Dpushp/UAV-uGV-system/PCB Design files/pcb schematics .png

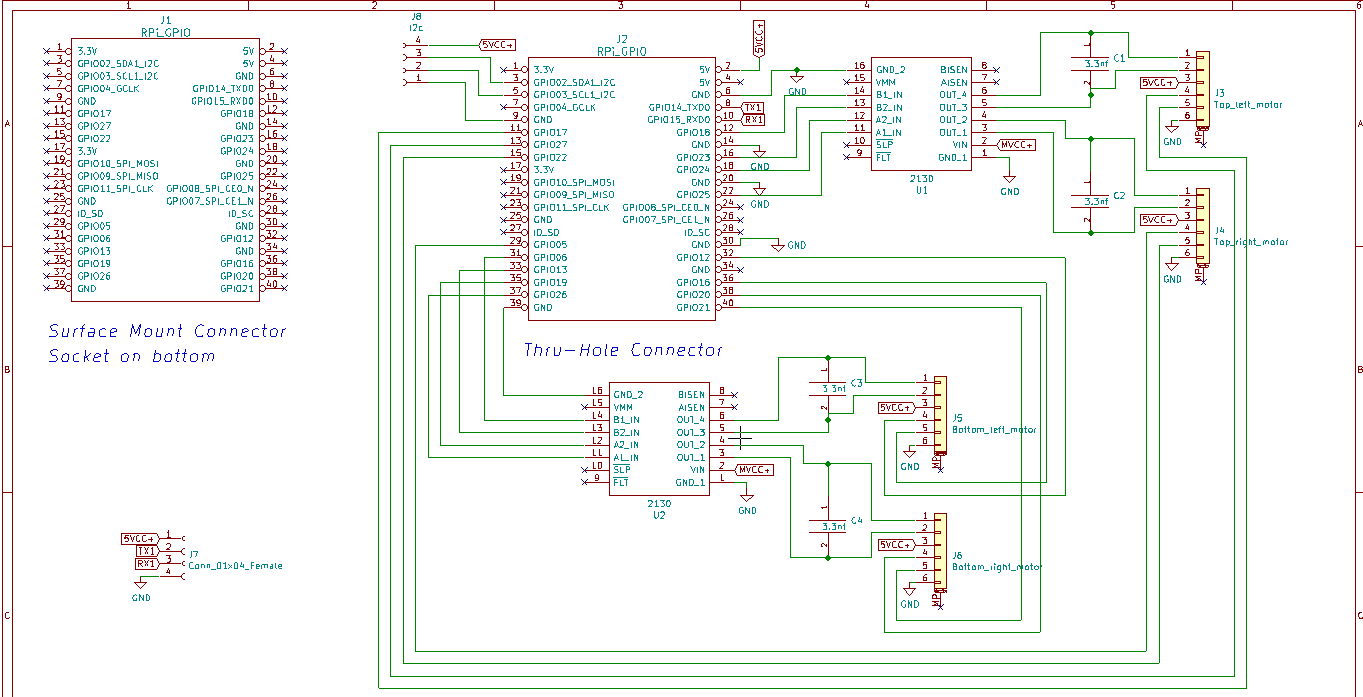
PCB Design files/pcb schematics .png
