Dpushp/UAV-uGV-system/ROS/src/realsense-ros/realsense2_description/meshes/plug.stl

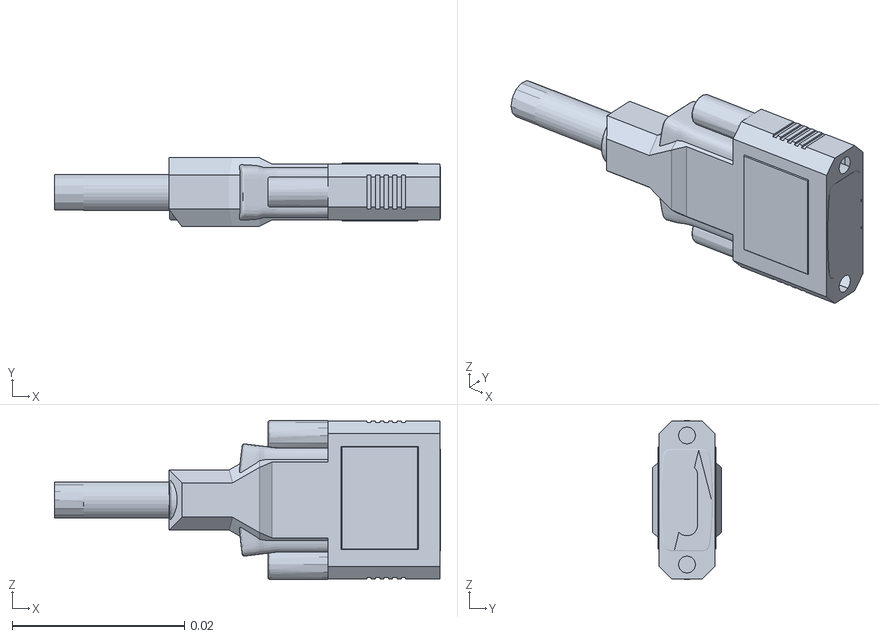
[picture p12: CAD file, 2021-03-01]
ROS/src/realsense-ros/realsense2_description/meshes/plug.stl
0.0448 x 0.008 x 0.0185
