Dpushp/UAV-uGV-system/ROS/src/robomax_description/description/meshes/epm.stl

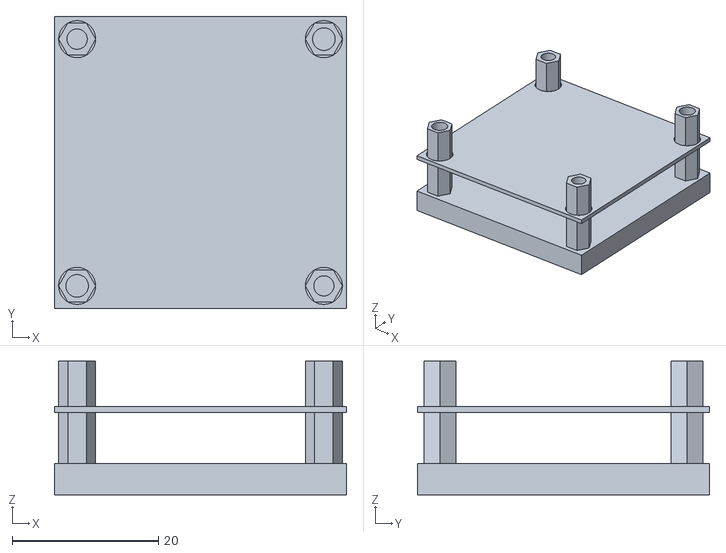
[picture p13: CAD file, 2021-03-01]
ROS/src/robomax_description/description/meshes/epm.stl
40.0 x 40.0 x 18.3
