Dpushp/UAV-uGV-system/ROS/src/robomax_description/description/meshes/kinect_camera/kinect_camera_simple.stl

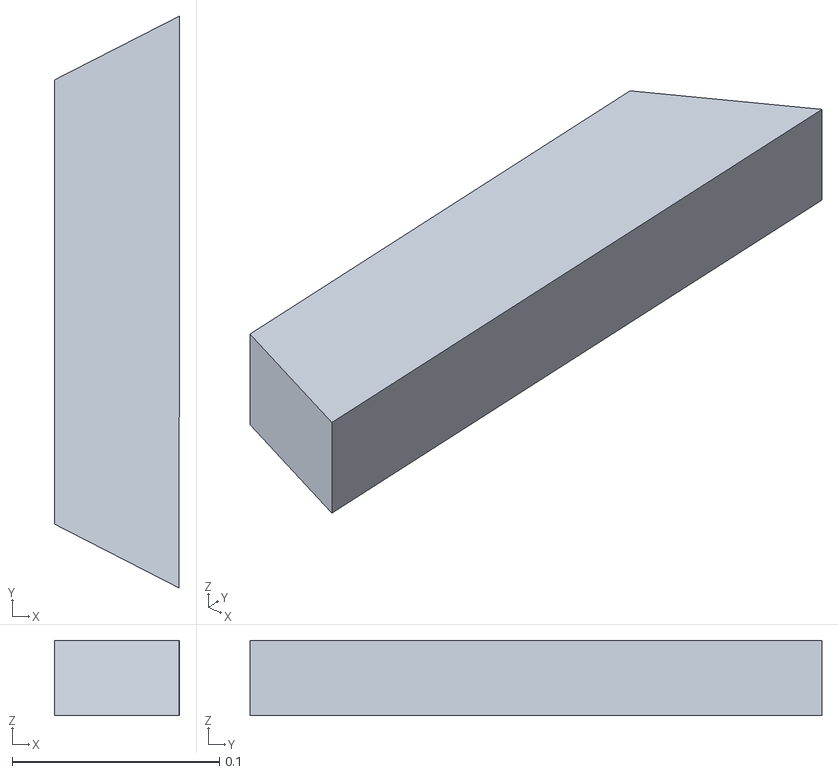
[picture p14: CAD file, 2021-03-01]
ROS/src/robomax_description/description/meshes/kinect_camera/kinect_camera_simple.stl
0.0604 x 0.276 x 0.0364
