Dpushp/UAV-uGV-system/ROS/src/realsense-ros/realsense2_description/meshes/plug_collision.stl

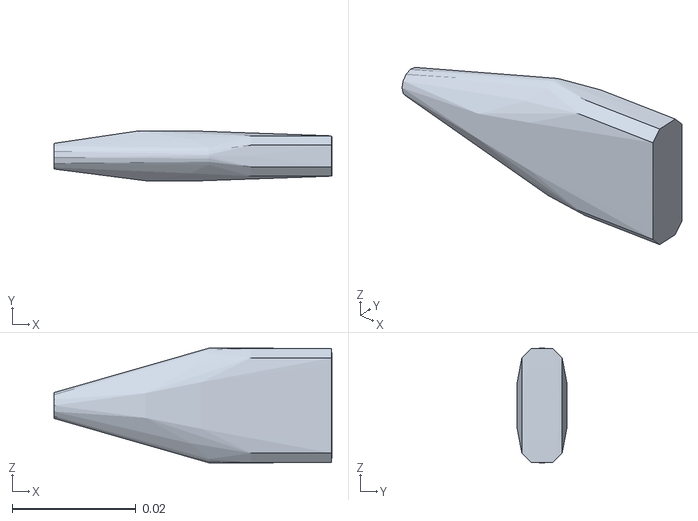
[picture p15: CAD file, 2021-03-01]
ROS/src/realsense-ros/realsense2_description/meshes/plug_collision.stl
0.0448 x 0.008 x 0.0185
