Dpushp/UAV-uGV-system/ROS/src/robomax_description/description/meshes/robomax_body.stl

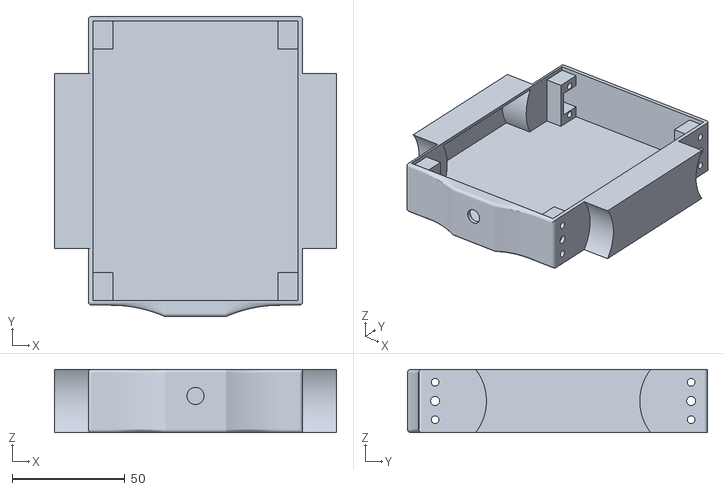
[picture p16: CAD file, 2021-03-01]
ROS/src/robomax_description/description/meshes/robomax_body.stl
125.0 x 133.0 x 28.0
