Dpushp/UAV-uGV-system/ROS/src/robomax_description/description/meshes/wheels.STEP

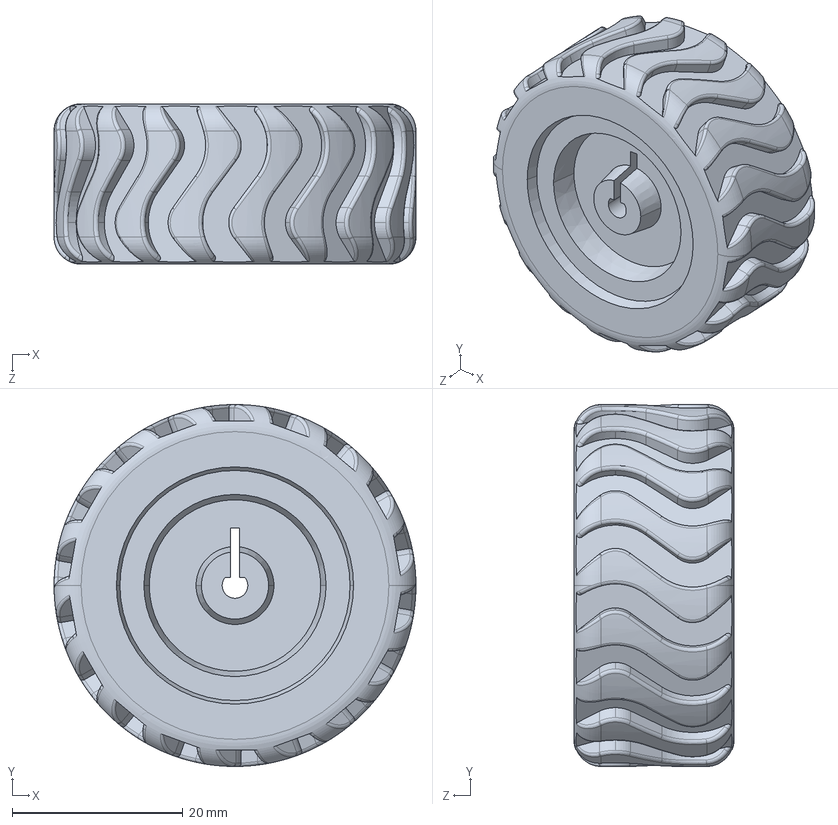
[picture p17: CAD file, 2021-03-01]
ROS/src/robomax_description/description/meshes/wheels.STEP
42.4 x 42.4 x 18.8 mm
