Dpushp/UAV-uGV-system/ROS/src/robomax_description/description/meshes/robomax_lid.stl

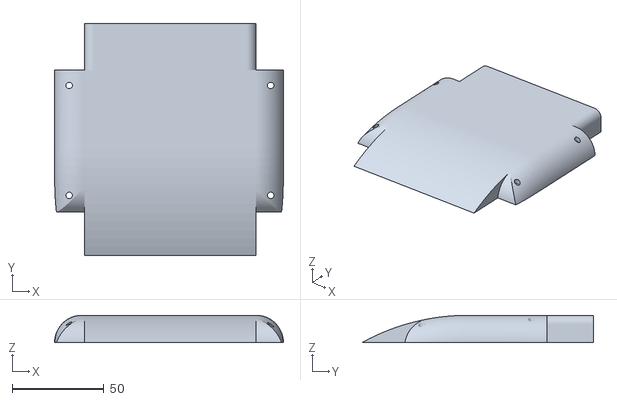
[picture p18: CAD file, 2021-03-01]
ROS/src/robomax_description/description/meshes/robomax_lid.stl
125.0 x 126.5 x 15.0
