Dpushp/UAV-uGV-system/(list of files, cad)

Other CAD files:
ROS/src/robomax_description/description/meshes/wheels.stl
