Dpushp/UAV-uGV-system/ROS/frames.pdf

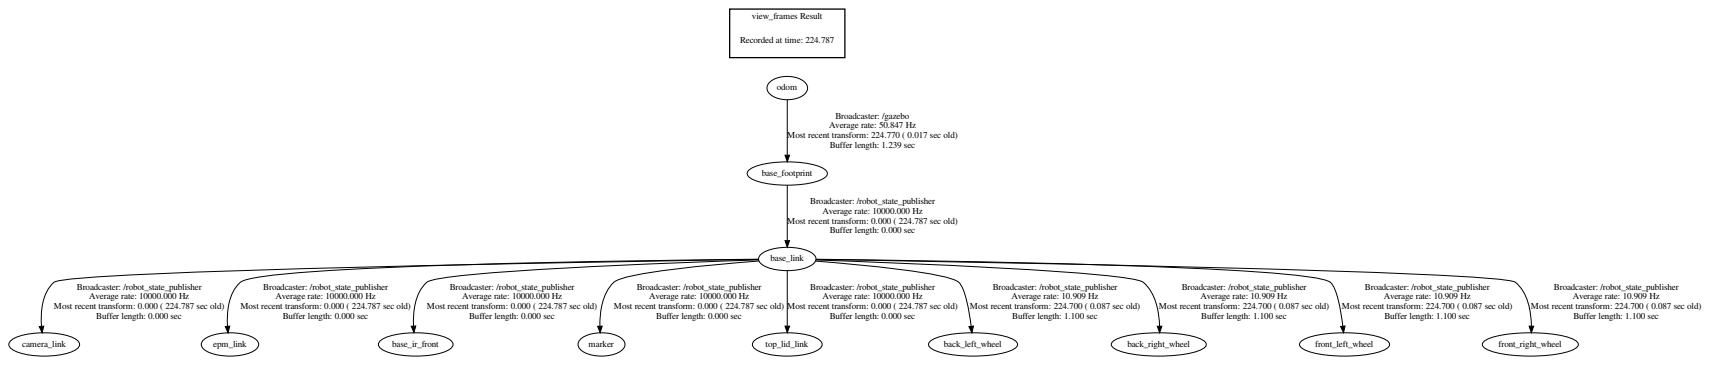
[picture p19: page 1]
view_frames Result; odom; base_footprint; base_link; camera_link; epm_link; base_ir_front; marker; top_lid_link; back_left_wheel; back_right_wheel; front_left_wheel; front_right_wheel

Recorded at time: 224.787

Broadcaster: /gazebo
Average rate: 50.847 Hz
Buffer length: 1.239 sec

Most recent transform: 224.770 ( 0.017 sec old)

Broadcaster: /robot_state_publisher
Average rate: 10000.000 Hz
Buffer length: 0.000 sec

Most recent transform: 0.000 ( 224.787 sec old)

Average rate: 10.909 Hz
Buffer length: 1.100 sec

Most recent transform: 224.700 ( 0.087 sec old)
